glocklueng/gnuRadio-hw/usrp2/documentation/usrp2.JPG

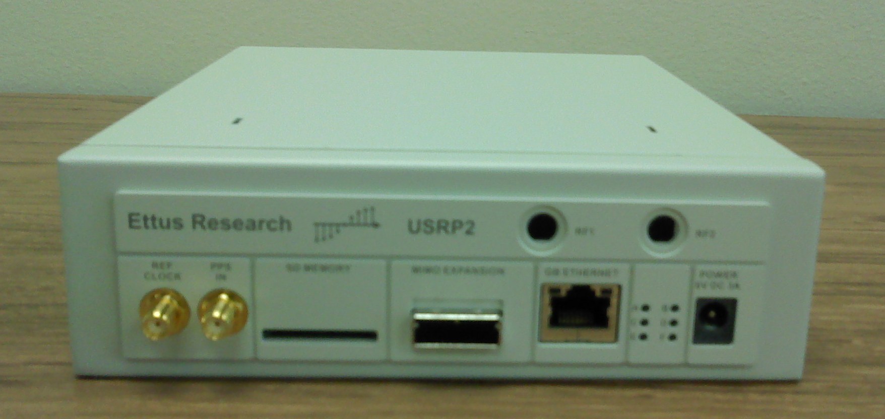
usrp2/documentation/usrp2.JPG
