glocklueng/gnuRadio-hw/usrp1/xy/USRP_2.JPG

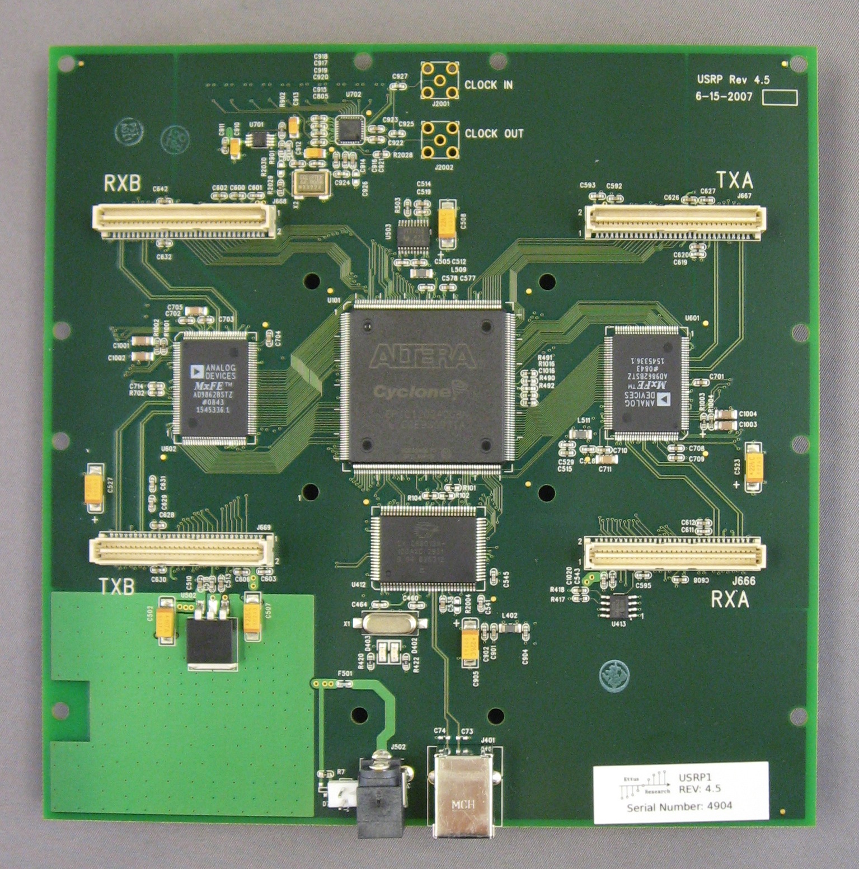
usrp1/xy/USRP_2.JPG
