glocklueng/gnuRadio-hw/usrp1/usrp-bom.xls

USRP-B REV B | 2006-01-31
Device | Value | Supplier | Part Number | Cal Chip Description | Footprint | Quantity | Refdes | Comments | Need | Have | Buy
CAPACITOR | 0.1uF | Cal Chip | GMC10X7R104K50NT | CAP CERAMIC 0603 X7R .1UF 10% 50V | 603 | 90 | C470 C510 C512 C513 C514 C515 C516 C522 C525 C530 C532 C534 C536 C538 C540 C542 C544 C546 C548 C551 C553 C555 C557 C559 C561 C563 C565 C566 C568 C570 C572 C575 C577 C579 C580 C582 C584 C586 C588 C590 C592 C594 C596 C598 C600 C602 C604 C606 C608 C610 C612 C614 C616 C618 C620 C622 C624 C626 C628 C630 C632 C634 C636 C638 C640 C642 C644 C701 C702 C703 C704 C706 C708 C709 C710 C712 C714 C803 C901 C903 C911 C914 C916 C917 C918 C919 C920 C921 C922 C923 |  | 9000 | 3000 | 6000
CAPACITOR | 10uF | Cal Chip | GMC31X7R106K16NT | CAP CERAMIC 1206 X7R 10UF 10% 16V | 1206 | 4 | C705 C707 C711 C713 | VOLTAGE, TOL., MATERIAL | 400 | 1000 | -600
CAPACITOR | 1uF | Cal Chip | GMC 31X7R105K25NT | CAP CERAMIC 1206 X7R 1UF 10% 16V | 1206 | 4 | C1001 C1002 C1003 C1004 |  | 400 | 1200 | -800
CAPACITOR | 220pF | Cal Chip | GMC10CG221J50NT | CAP CERAMIC 0603 NPO/COG 220PF 10% 50V | 603 | 75 | C1014 C1015 C1016 C1020 C505 C518 C519 C524 C526 C528 C529 C531 C533 C535 C537 C539 C541 C543 C545 C547 C549 C550 C552 C554 C556 C558 C560 C562 C564 C567 C569 C571 C573 C574 C576 C578 C581 C583 C585 C587 C589 C591 C593 C595 C597 C599 C601 C603 C605 C607 C609 C611 C613 C615 C617 C619 C621 C623 C625 C627 C629 C631 C633 C635 C637 C639 C641 C643 C645 C805 C902 C904 C924 C925 C927 |  | 7500 | 4800 | 2700
CAPACITOR | 22pF | Cal Chip | GMC10CG220J50NT | CAP CERAMIC 0603 NPO/COG 22PF 10% 50V | 603 | 2 | C460 C464 |  | 200 | 2500 | -2300
CAPACITOR | 470pF | Cal Chip | GMC10CG471J50NT | CAP CERAMIC 0603 NPO/COG 470PF 5% 50V | 603 | 1 | C912 |  | 100 | 2200 | -2100
CAPACITOR | NONE |  |  |  | 603 | 1 | C926 |  | 100 | 100 | 0
CONNECTOR_3 | POWER | DigiKey | SC1153-ND |  | RAPC722 | 1 | J502 |  | 100 | 0 | 100
CONNECTOR_4 | USB | DigiKey | WM17113-ND |  | USB | 1 | J401 |  | 100 | 0 | 100
CRYSTAL | 24 Mhz | DigiKey | XC742CT-ND |  | HC-49USMD | 1 | X1 |  | 100 | 400 | -300
FUSE | 3A | DigiKey | P11359-CT-10 |  | 603 | 1 | F501 |  | 100 | 0 | 100
HEADER4 | SIP4 | DNS |  |  | SIP4 | 1 | J1001
INDUCTOR | Ferrite Bead | DigiKey | 240-2405-1-ND |  | 1206 | 7 | L401 L402 L509 L510 L511 L600 L601 |  | 700 | 300 | 400
LED | CMD17-21VGC/TR8 | DigiKey | L62405CT-ND |  | unknown | 2 | D402 D403 |  | 200 | 0 | 200
POLARIZED_CAPACITOR | 100uF Tan Size-C LoESR | SMC | AVX TPSC107K010R0100 | 100UF 10V C LOW ESR 100mR | SIZE-C | 1 | C502 | 10V ESR RATING?? | 100 | 0 | 100
POLARIZED_CAPACITOR | 22uF Tan Size-C LoESR | SMC | DK PN 495-1522-2-ND | 22UF 10V C LOW ESR 100mR | SIZE-C | 5 | C507 C508 C523 C527 C905 | 10V ESR RATING?? | 500 | 200 | 300
POLARIZED_CAPACITOR | 4.7uF | SMC | AVX TAJA475K016RNJ | CAP TANT 4.7UF 10V A CASE 10% | 1206 | 3 | C910 C913 C915 | TANTALUM A CASE = 1206 | 300 | 800 | -500
RESISTOR | 0 | Cal Chip | RM06J000CT | 0603 0 OHM | 603 | 6 | R2002 R2003 R2029 R442 R859 R861 |  | 600 | 2500 | -1900
RESISTOR | 10 | Cal Chip | RM06F10R0CT | 0603 1% 10 OHM | 603 | 1 | R2028 | ALSO AVAILABLE IN 5% TOL RM06J100CT | 100 | 2500 | -2400
RESISTOR | 100 | Cal Chip | RM06F1000CT | 0603 1% 100 OHM | 603 | 4 | R1001 R1002 R1003 R1004 | ALSO AVAILABLE IN 5% TOL RM06J101CT | 400 | 3000 | -2600
RESISTOR | 100K | Cal Chip | RM06F1003CT | 0603 1% 100KR | 603 | 1 | R424 | ALSO AVAILABLE IN 5% TOL RM06J104CT | 100 | 3000 | -2900
RESISTOR | 10K | Cal Chip | RM06F1002CT | 0603 1% 10KR | 603 | 6 | R101 R102 R104 R490 R491 R492 | ALSO AVAILABLE IN 5% TOL RM06J103CT | 600 | 2500 | -1900
RESISTOR | 140K | Cal Chip | RM06F1403CT | 0603 1% 140KR | 603 | 1 | R901 |  | 100 | 3000 | -2900
RESISTOR | 1K | Cal Chip | RM06F1001CT | 0603 1% 1KR | 603 | 2 | R420 R422 | ALSO AVAILABLE IN 5% TOL RM06J102CT | 200 | 2500 | -2300
RESISTOR | 2.2K | Cal Chip | RM06J222CT | 0603 5% 2.2KR | 603 | 2 | R417 R418 |  | 200 | 3000 | -2800
RESISTOR | 240K | Cal Chip | RM06J244CT | 0603 5% 240KR | 603 | 1 | R503 |  | 100 | 2000 | -1900
RESISTOR | 4.12K | Cal Chip | RM06F4121CT | 0603 1% 4.12K | 603 | 1 | R903 |  | 100 | 3000 | -2900
RESISTOR | 4K | Cal Chip | RM06F4021CT | 0603 1% 4.02KR | 603 | 2 | R701 R702 | 4K NON STD VALUE 4.02K 1% | 200 | 3000 | -2800
RESISTOR | 50 | Cal Chip | RM06F49R9CT | 0603 1% 49.9 OHM | 603 | 6 | R1011 R1012 R1013 R1014 R1015 R1016 | 50 OHM IS NON STD VALUE 51 OHM 5% 49.9 OHM 1% ARE STD VALUES | 600 | 2500 | -1900
RESISTOR | 78.7K | Cal Chip | RM04F7872CT | 0402 1% 78.7K | 603 | 1 | R902 |  | 100 | 3000 | -2900
RESISTOR | NONE |  |  |  | 402 | 22 | R904 R905 R907 R908 R910 R911 R913 R914 R916 R917 R919 R920 R922 R923 R925 R926 R928 R929 R931 R932 R934 R935 R906 R909 R912 R915 R918 R921 R924 R927 R930 R933 R936 |  | 2200 | 8500 | -6300
RESISTOR | NONE |  |  |  | 603 | 6 | R2001 R2004 R2005 R2030 R858 R860
SMA | NONE |  |  |  | SMA_VERT | 2 | J2001 J2002
TPS77715PWP | TPS77715PWP | ETTUS |  |  | PWP-20 | 1 | U503 |  | 100 | 100 | 0
CTX286LVCT-ND | 64 Mhz | DigiKey, ETTUS | CTX286LVCT-ND |  | vctcxo | 1 | X2 |  | 100 | 400 | -300
24LC02B |  | ETTUS | Cross PN 24LCO24 |  | SO8 | 1 | U413 |  | 100 | 100 | 0
AD9513 |  | ETTUS |  |  | LFCSP32 | 1 | U702 |  | 100 |  | 100
AD9862 |  | ETTUS |  |  | LQFP128 | 2 | U601 U602 |  | 200 |  | 200
ADP3336 |  | ETTUS |  |  | MSOP8 | 1 | U701 |  | 100 | 150 | -50
CY7C68013-TQ100 |  | ETTUS | Cross PN CY7C68013A-100AXC | second cross CY7C68013-100AXC | TQFP100 | 1 | U412 |  | 100 | 4 | 96
EP1C12-PQ240 |  | ETTUS | Cross PN EP1C12Q240C8N |  | PQ240 | 1 | U101 |  | 100 | 82 | 18
LT1085CM-3.3 | LT1085CM-3.3 | ETTUS |  |  | LT1085 | 1 | U502 |  | 100 | 100 | 0
PMC64 | PMC 71436-2164 | ETTUS |  |  | pmc | 4 | J666 J667 J668 J669 |  | 400 | 5 | 395
USRP-B PCB REV 4.1 | PC board | ETTUS |  |  |  | 1 |  |  | 100 |  | 100
