glocklueng/gnuRadio-hw/daughterBoards/basic-lf/lfrx-bom.xls

Device | Value | Footprint | quantity | Supplied By | refdes
24LC025B |  | SO8 | 1 | ETTUS | U1
AD8132 |  | SO8 | 2 | ETTUS | U2 U3
CAPACITOR | .1uF | 603 | 1 | Bestek | C24
CAPACITOR | 82pF | 603 | 4 | Bestek | C22 C23 C25 C26
HEADER10 |  | CONNECTOR 5 2 | 1 | Bestek | J17
HEADER16 |  | CONNECTOR 8 2 | 3 | Bestek | J16 J24 J25
HEADER20 |  | CONNECTOR 10 2 | 1 | Bestek | J15
PMC64 |  | PMC-REVERSE | 1 | ETTUS | J2
RESISTOR | 0 | 603 | 1 | Bestek | R28
RESISTOR | 1K | 603 | 2 | Bestek | R6 R7
RESISTOR | 24.9 | 603 | 2 | Bestek | R32 R35
RESISTOR | 348 | 603 | 8 | Bestek | R30 R31 R33 R34 R36 R37 R38 R39
RESISTOR | 49.9 | 603 | 2 | Bestek | R3 R4 R5 R9 R10 R11
SMA |  | SMA | 2 | ETTUS | J18 J19
