glocklueng/gnuRadio-hw/daughterBoards/basic-lf/lftx-bom.xls

Device | Value | Footprint | quantity | Supplier | refdes
CAPACITOR | 0.1uF | 603 | 6 |  | C12 C20 C22 C23 C6 C8
CAPACITOR | 100pF | 603 | 2 |  | C31 C32
CAPACITOR | 1uF | 603 | 2 |  | C1 C2
CAPACITOR | 20pF | 603 | 2 |  | C14 C15
CAPACITOR | 220pF | 603 | 3 |  | C10 C21 C5
CAPACITOR | 22pF | 603 | 1 |  | C4
CAPACITOR | 4.7pF | 603 | 2 |  | C33 C34
HEADER10 |  | CONNECTOR 5 2 | 1 |  | J47
HEADER16 |  | CONNECTOR 8 2 | 3 |  | J46 J50 J51
HEADER20 |  | CONNECTOR 10 2 | 1 |  | J45
FERRITE BEAD |  | 1206 | 2 |  | FB1 FB2
RESISTOR | 0 | 603 | 1 |  | R29
RESISTOR | 178K | 603 | 1 |  | R2
RESISTOR | 225 | 603 | 4 |  | R3 R5 R6 R8
RESISTOR | 25 | 603 | 8 |  | R33 R34 R35 R36 R38 R39 R40 R41
RESISTOR | 500 | 603 | 4 |  | R32 R37 R4 R7
RESISTOR | 68.1K | 603 | 1 |  | R1
24LC025B | unknown | SO8 | 1 | ETTUS | U52
CAPACITOR | 4.7uF | 1206 | 2 | ETTUS | C11 C3
INDUCTOR | 22uH | 1206 | 2 | ETTUS | L1 L2
LT3462 |  | TSOT23 | 1 | ETTUS | U3
AD8047 |  | SO8 | 2 | ETTUS | U1 U2
PMC64 |  | PMC-REVERSE | 1 | ETTUS | J44
SMA5 |  | SMA_VERT | 2 | ETTUS | J48 J49
