glocklueng/gnuRadio-hw/daughterBoards/dbsrx/dbsrx-bom.xls

Device | Value | Mfg part number | Footprint | Qty | Supplier | Refdes | Cost
CAPACITOR | .01uF |  | 603 | 2 | Bestek | C83 C87
CAPACITOR | .1uF |  | 603 | 11 | Bestek | C100 C183 C184 C187 C24 C27 C61 C63 C68 C69 C84
CAPACITOR | .22uF |  | 603 | 2 | Bestek | C70 C71
CAPACITOR | 1000pF |  | 603 | 10 | Bestek | C124 C28 C74 C75 C76 C77 C78 C79 C80 C81
CAPACITOR | 100pF |  | 603 | 5 | Bestek | C25 C26 C64 C65 C97
CAPACITOR | 10nF |  | 603 | 1 | Bestek | C98
CAPACITOR | 200pF |  | 603 | 1 | Bestek | C261
CAPACITOR | 22pF |  | 603 | 4 | Bestek | C66 C67 C85 C86
CAPACITOR | 3300pF |  | 603 | 1 | Bestek | C59
CAPACITOR | 47pF |  | 603 | 4 | Bestek | C72 C73 C96 C99
POLARIZED_CAPACITOR | 100uF |  | EIA6032 | 1 | Bestek | C82
CONNECTOR_2 |  |  | CONNECTOR 1 2 | 1 | Bestek | J100 J101
HEADER16 |  |  | CONNECTOR 8 2 | 2 | Bestek | J24 J25
INDUCTOR | 27nH | Coilcraft 0603CS-27NX_BU | 603 | 2 | Bestek | L98 L100
INDUCTOR | MI1206K601R-00 |  | 1206 | 2 | Bestek | L600 L601
RESISTOR | 10 |  | 603 | 1 | Bestek | R193
RESISTOR | 1K |  | 603 | 4 | Bestek | R13 R21 R6 R7
RESISTOR | 2.21K |  | 603 | 1 | Bestek | R14
RESISTOR | 1K, 0.1% |  | 603 | 8 | Bestek | R17 R18 R19 R20 R65 R66 R67 R68 |  |  |  | CHANGED!!!!
RESISTOR | 4.7 |  | 603 | 1 | Bestek | R12
RESISTOR | 43.2 |  | 603 | 1 | Bestek | R9
RESISTOR | 50 |  | 603 | 5 | Bestek | R10 R15 R16 R71 R93
RESISTOR | 75 |  | 603 | 1 | Bestek | R11
RESISTOR | 86.6 |  | 603 | 1 | Bestek | R40
RESISTOR | NONE |  | 603 | 1 | NP | R22
 |  |  |  |  |  |  | Cost | Have | Short? | Ordered
PCB |  |  |  | 1 | Ettus |  | 15 | 0 | -100 | Yes
24LC024/SN |  |  | SO8 | 1 | Ettus | U1 | 0.5 | 100 | 0
SMA |  |  | SMA_VERT | 1 | Ettus | J3 | 1.5 | 100 | 0
MAX2118 |  |  | QFN40_6_EP | 1 | Ettus | U3 | 3.5 | 100 | 0
NDS355AN |  |  | SOT23 | 1 | Ettus | Q1 | 0.5 | 100 | 0
POLARIZED_CAPACITOR | 22uF |  | EIA6032 | 1 | Ettus | C182 | 1 | 100 | 0
PMC64 |  |  | PMC-REVERSE | 1 | Ettus | J2 | 1.35 | 100 | 0
AD8132 |  |  | SO8 | 2 | Ettus | U5 U6 | 3.8 | 0 | -200 | Yes
LM2940IMP |  |  | SOT223 | 1 | Ettus | U2 | 1 | 100 | 0
MGA82563 |  |  | SC70_6 | 1 | Ettus | U4 | 1.25 | 100 | 0
 |  |  |  |  |  |  | 29.4
