glocklueng/gnuRadio-hw/daughterBoards/rfx/flex400-bom.xls

FLEX 400
Type | Value | Footprint | Quantity | Refdes | Supplier | Part Number
CAPACITOR | .01uF | 603 | 14 | C159 C160 C161 C163 C172 C173 C183 C59 C60 C61 C63 C80 C81 C98 | CalChip | GMC10X7R103K50NT
CAPACITOR | .1uF | 603 | 18 | C3 C33 C82 C83 C84 C95 C120 C121 C124 C125 C129 C203 C209 C34 C35 C45 C5 C9 | CalChip | GMC10X7R104K50NT
CAPACITOR | 1000pF | 603 | 23 | C101 C103 C104 C108 C157 C158 C162 C184 C201 C202 C204 C205 C206 C54 C57 C58 C62 C64 C93 C94 C96 C170 C70 | CalChip | GMC10X7R102K50NT
CAPACITOR | 100pF | 603 | 3 | C105 C106 C97 | CalChip | GMC10CG101J50NT
CAPACITOR | 10uF | 1206 | 2 | C171 C71 | CalChip | GMC31X7R106K16NT
CAPACITOR | 12nF | 603 | 2 | C168 C68 | CalChip | GMC10X7R123K50NT
CAPACITOR | 12pF | 603 | 1 | C222 | CalChip | GMC10CG120J50NT
CAPACITOR | 150pF | 603 | 2 | C86 C90 | CalChip | GMC10CG151J50NT
CAPACITOR | 15pF | 603 | 1 | C102 | CalChip | GMC10CG150J50NT
CAPACITOR | 1uF | 603 | 10 | C107 C109 C122 C123 C164 C207 C240 C4 C46 C53 | CalChip | GMC10X7R105K16NT
CAPACITOR | 220pF | 603 | 7 | C128 C182 C186 C2 C200 C32 C8 | CalChip | GMC10CG221J50NT
CAPACITOR | 3.9pF | 603 | 4 | C221 C223 C65 C66 | CalChip | GMC10CG3R9B50NT
CAPACITOR | 390pF | 603 | 2 | C169 C69 | CalChip | GMC10CG391J50NT
CAPACITOR | 4.7pF | 603 | 2 | C88 C92 | CalChip | GMC10CG4R7B50NT
CAPACITOR | 470pF | 603 | 5 | C1 C10 C110 C111 C210 | CalChip | GMC10CG471J50NT
CAPACITOR | 68pF | 603 | 4 | C174 C175 C177 C178 | CalChip | GMC10CG680J50NT
CAPACITOR | 8.2pF | 603 | 4 | C165 C166 C87 C91 | CalChip | GMC10CG8R2B50NT
CAPACITOR | 820pF | 603 | 2 | C167 C67 | CalChip | GMC10CG821J50NT
CAPACITOR | 82pF | 603 | 2 | C85 C89 | CalChip | GMC10CG820J50NT
CAPACITOR | NONE | 603 | 4 | C185 C224 C225 C36
INDUCTOR | 0.68uH | 1008 | 2 | L1 L2 | Mouser | NLV25T-R68J-PF
INDUCTOR | 1.2uH | 1008 | 2 | L3 L4 | Mouser | NLV25T-1R2JPF
INDUCTOR | 100nH | 603 | 6 | L101 L104 L113 L180 L181 L98 | CoilCraft | 0603CS-R10XJBW
INDUCTOR | 10nH | 603 | 1 | L102 | CoilCraft | 0603CS-10NXJBW
INDUCTOR | 16nH | 603 | 2 | L182 L183 | CoilCraft | 0603CS-16NXJBW
INDUCTOR | 22nH | 603 | 2 | L224 L225 | CoilCraft | 0603CS-22NXGLW
INDUCTOR | 4.3nH | 402 | 4 | L105 L116 L31 L32 | CoilCraft | 0402CS-4N3XGLW
INDUCTOR | 47nH | 603 | 2 | L80 L81 | CoilCraft | 0603CS-47NXGLW
INDUCTOR | 6.8nH | 603 | 1 | L99 | CoilCraft | 0603CS-6N8XJBW
INDUCTOR | 620nH | 1008 | 4 | L186 L187 L190 L191 | CoilCraft | 1008CS-621XJBC
INDUCTOR | 8.2nH | 603 | 2 | L82 L83 | CoilCraft | 0603CS-8N2XJBW
INDUCTOR | NONE | 603 | 3 | L221 L222 L223
INDUCTOR | Ferrite Bead | 1206 | 7 | L103 L112 L114 L202 L5 L6 L7 | DigiKey | 240-2405-2-ND
RESISTOR | 0 | 603 | 11 | R117 R130 R132 R136 R142 R35 R40 R42 R46 R64 R95 | CalChip | RM06J000CT
RESISTOR | 1.6K | 603 | 2 | R121 R32 | CalChip | RM06J162CT
RESISTOR | 10 1% | 603 | 3 | R103 R110 R9 | CalChip | RM06F10R0CT
RESISTOR | 100 1% | 603 | 4 | R104 R111 R7 R8 | CalChip | RM06F1000CT
RESISTOR | 10K | 603 | 2 | R249 R250 | CalChip | RM06F1002CT
RESISTOR | 140K | 603 | 3 | R140 R201 R62 | CalChip | RM06F1403CT
RESISTOR | 174 | 603 | 1 | R14 | CalChip | RM06F1740CT
RESISTOR | 1K | 603 | 2 | R10 R11 | CalChip | RM06F1001CT
RESISTOR | 2 | 603 | 4 | R3 R4 R5 R6 | CalChip | RM06J2R0CT
RESISTOR | 200 | 603 | 4 | R47 R48 R49 R50 | CalChip | RM06F2000CT
RESISTOR | 210K | 603 | 2 | R141 R63 | CalChip | RM06F2103CT
RESISTOR | 3.32K | 603 | 2 | R152 R83 | CalChip | RM06F3321CT
RESISTOR | 3.3K | 603 | 2 | R120 R38 | CalChip | RM06J332CT
RESISTOR | 4.02K | 603 | 1 | R68 | CalChip | RM06F4021CT
RESISTOR | 4.7K | 603 | 2 | R119 R33 | CalChip | RM06F4751CT
RESISTOR | 470 | 402 | 4 | R105 R106 R30 R31 | CalChip | RM04J471CT
RESISTOR | 49.9 1% | 603 | 7 | R101 R102 R108 R109 R107 R37 R118 | CalChip | RM06F49R9CT
RESISTOR | 57.6 | 603 | 1 | R18 | CalChip | RM06F57R6CT
RESISTOR | 64.9K | 603 | 2 | R151 R81 | CalChip | RM06F6492CT
RESISTOR | 78.7K | 603 | 2 | R80 R150 R202 | CalChip | RM04F7872CT
RESISTOR | 95.3 | 603 | 2 | R61 R87 | CalChip | RM06F95R3CT
RESISTOR | NONE | 603 | 14 | R115 R116 R133 R134 R135 R153 R34 R36 R43 R44 R45 R84 R96 R97
CONNECTOR_2 |  | CONNECTOR2 | 2 | J100 J3 | TTI Inc | 22-28-4021
HEADER16 |  | CONNECTOR16 | 2 | J101 J24 | Mouser | 10-89-7402 | Normally 10-89-7162
HEADER16, AN 8X2, WILL BE A 20X2 THAT WILL BE CUT DOWN BY ASEMTEC
PCB FAB REV 1 |  | Flex 400 Rev 1 |  |  | Ettus
Consigned Parts |  |  |  |  | Ettus
RF3315 |  | SOT89 | 1 | U105 | Ettus
CTX286LVCT-ND |  | VCTCXO | 2 | X1 X101 | Ettus
24LC025B |  | SO8 | 2 | U1 U102 | Ettus
74AC04 |  | SO14 | 1 | U204 | Ettus
AD8348 |  | TSSOP28/0.65 | 1 | U2 | Ettus
AD8345 |  | TSSOP16-65-PAD | 1 | U101 | Ettus
ADF4360-7 |  | CP-24 | 2 | U103 U3 | Ettus
ADP3336 |  | MSOP8 | 5 | U110 U111 U203 U5 U6 | Ettus
SMA |  | SMA_VERT | 2 | J200 J202 | Ettus
AD8052 |  | SO8 | 1 | U7 | Ettus
HMC174MS8 |  | MSOP8 | 2 | U202 U209 | Ettus
HMC311ST89 |  | SOT89 | 1 | U104 | Ettus
MGA6x563 |  | SOT363 | 1 | U4 | Ettus
PMC64 |  | PMC-REVERSE | 2 | J1 J102 | Ettus
TANTALUM | 4.7uF | 1206 | 7 | C117 C126 C127 C208 C47 C6 C7 | Ettus
