glocklueng/gnuRadio-hw/daughterBoards/rfx/flex900-bom.xls

2006-03-28 | revised by Mike Ysenbart SEMS
Device | Value | Footprint | Qty | Supplier | P/N | REFDES | stockparts
24LC025B |  | SO8 | 2 | ETTUS |  | U1 U102
74AC04 |  | SO14 | 1 | ETTUS |  | U204
AD8347 |  | TSSOP28/0.65 | 1 | ETTUS |  | U2
AD8349 |  | TSSOP16-65-PAD | 1 | ETTUS |  | U101
ADF4360-3 |  | CP-24 | 2 | ETTUS |  | U103 U3
ADP3336 |  | MSOP8 | 5 | ETTUS |  | U110 U111 U203 U5 U6
SMA |  | SMA | 2 | ETTUS |  | J200 J202
RF3315 |  | SOT89 | 1 | ETTUS |  | U105
SAWTEK856327 |  | SAWTEK856327 | 1 | ETTUS |  | FIL1
VCTCXO |  | CTX286LVCT-ND | 2 | ETTUS |  | X1 X101
AD8052 |  | SO8 | 1 | ETTUS |  | U7
HMC574MS8 |  | MSOP8 | 2 | ETTUS |  | U202 U209 | 2006-02-23
MGA82563 |  | SOT363 | 2 | ETTUS |  | U104 U4
PMC64 |  | PMC-REVERSE | 2 | ETTUS | Bottom of board | J1 J102
CAPACITOR | .01uF | 10% 50V 0603 | 11 | CalChip | GMC10X7R103K50NT | C108 C112 C161 C163 C172 C173 C183 C61 C63 C80 C81
CAPACITOR | 0.1uF | 10%…50V…0603 | 24 | CalChip | GMC10X7R104K50NT | C120 C121 C124 C125 C129 C203 C209 C3 C33 C34 C35 C45 C5 C82 C83 C84 C9 C95 C159 C160 C59 C60 C74 C98
INDUCTOR | 4.7nH | NPO/COG 50V..+/- 0.1pF 0603 | 1 | CoilCraft | 0603CS-4N7XJLW | C102
CAPACITOR | 1000pF | 10%..50V..0603 | 9 | CalChip | GMC10X7R102K50NT | C162 C170 C184 C54 C62 C64 C67 C70 C167
CAPACITOR | 220pF | 5%..50V..0603 | 25 | CalChip | GMC10CG221J50NT | C101 C104 C105 C106 C157 C158 C201 C202 C204 C205 C206 C57 C58 C75 C93 C94 C96 C97 C128 C182 C186 C2 C200 C32 C8
CAPACITOR | 10uF | 10%..16V..1206 | 2 | CalChip | GMC31X7R106K16NT | C171 C71 | stock
CAPACITOR | 120pF | NPO/COG.5%.50V.0603 | 2 | CalChip | GMC10CG121J50NT | C175 C178
CAPACITOR | 150pF | NPO/COG.5%.50V.0603 | 2 | CalChip | GMC10CG151J50NT | C86 C90
CAPACITOR | 6pF | NPO/COG.50V | 1 | CalChip | GMC10CG6R0B50NT | C103
CAPACITOR | 1uF | 10%.16V..0603 | 10 | Digi-Key | 490-1536-1-ND | C107 C109 C122 C123 C164 C207 C240 C4 C46 C53
CAPACITOR | 4.7pF | NPO/COG..50V..0603 | 3 | CalChip | GMC10CG4R7B50NT | C88 C92 C199
CAPACITOR | 470pF | NPO/COG..5%.50V.0603 | 7 | CalChip | GMC10CG471J50NT | C1 C10 C69 C110 C111 C169 C210 | stock
CAPACITOR | 47pF | NPO/COG.5%.50V.0603 | 2 | CalChip | GMC10CG470J50NT | C174 C177
CAPACITOR | 8.2pF | NPO/COG.50V.0603 | 2 | CalChip | GMC10CG8R2B50NT | C87 C91
CAPACITOR | 82pF | NPO/COG.5%.50V.0603 | 2 | CalChip | GMC10CG820J50NT | C85 C89
CAPACITOR | 4.3pF | NPO/COG.10%.50V 1.2pF.0603 | 4 | CalChip | GMC10CG4R3B50NT | C65 C66 C165 C166
CAPACITOR | 0.015uF | 10%..50V..0603 | 2 | CalChip | GMC10X7R153K50NT | C68 C168
CAPACITOR | NONE | 603 | 2 | DNS |  | C185 C36
POLARIZED_CAPACITOR | 4.7uF | 1206 | 7 | AVX | TAJA475K016RNJ | C117 C126 C127 C208 C47 C6 C7 | stock
HEADER16 |  | 0.1" Header 20X2 | 2 | Allied Elect. | 10-89-7402 | J101 J24
CONNECTOR_2 |  | 0.1" Header 2X1 | 2 | Digi-Key | WM6602-ND | J100 J3 | 2006-02-22
INDUCTOR | 0.68uH | 1008 | 2 | Digi-Key | 445-1723-1-ND | L1 L2
INDUCTOR | 1.2uH | 1008 | 2 | Digi-Key | 445-1726-1-ND | L3 L4
INDUCTOR | 47nH | 603 | 7 | CoilCraft | 0603CS-47NXJLW | L101 L113 L98 L80 L81 L180 L181
INDUCTOR | 8.7nH | 603 | 5 | CoilCraft | 0603CS-8N7XJLW | L104 L82 L83 L182 L183
INDUCTOR | 330nH | 1008 | 4 | Digi-Key | PCD1214CT-ND | L186 L187 L190 L191
INDUCTOR | Ferrite Bead | 1206 | 9 | Digi-Key | 240-2405-1-ND | L103 L108 L112 L114 L202 L5 L6 L7 L8
RESISTOR | 0 | 603 | 13 | CalChip | RM06J000CT | R103 R110 R117 R130 R132 R136 R142 R35 R40 R42 R46 R64 R95
RESISTOR | 10 | 10 Ohms …….0603 | 1 | CalChip | RM06F10R0CT | R9
RESISTOR | 100 | 100 Ohms….…0603 | 2 | CalChip | RM06F1000CT | R7 R8
RESISTOR | 10K | 1%..…..0603 | 2 | Cal Chip | RM06F1002CT | R249 R250
RESISTOR | 140K | 1%…....0603 | 3 | Cal Chip | RM06F1403CT | R140 R201 R62
RESISTOR | 1K | 1%..…..0603 | 1 | CalChip | RM06F1001CT | R11
RESISTOR | 2 | 2 Ohm..5%…....0603 | 4 | CalChip | RM06J2R0CT | R3 R4 R5 R6
RESISTOR | 200 | 200 ohm 1%…….0603 | 6 | CalChip | RM06F2000CT | R18 R19 R47 R48 R49 R50
RESISTOR | 210K | 210K ohm 1%….…0603 | 2 | CalChip | RM06F2103CT | R141 R63
RESISTOR | 240 | 240 ohm …0.1%….…0603 | 2 | Digi-Key | RR08P240BCT-ND | R104 R111
RESISTOR | 3.32K | 1%…....0603 | 2 | CalChip | RM06F3321CT | R261 R262
RESISTOR | 4.7K | 1%…….0603 | 2 | CalChip | RM06F4751CT | R119 R33
RESISTOR | 40.2 | 1%…….0603 | 4 | CalChip | RM06F40R2CT | R101 R102 R108 R109
RESISTOR | 50 | 49.9 Ohm 1%…….0603 | 2 | CalChip | RM06F49R9CT | R118 R37
RESISTOR | 64.9K | 1%…….0603 | 2 | CalChip | RM06F6492CT | R151 R81
RESISTOR | 78.7K | 1%…….0603 | 3 | Cal Chip | RM04F7872CT | R150 R202 R80 | stock
RESISTOR | 95.3 | 1%…….0603 | 2 | CalChip | RM06F95R3CT | R61 R87
RESISTOR | NONE | 603 | 15 | DNS |  | R1 R115 R116 R133 R134 R135 R153 R34 R36 R43 R44 R45 R84 R96 R97
RESISTOR | 2K | 1%…….0603 | 5 | CalChip | RM06F2001CT | R10, R32,R38 R120 R121
PCB Fab |  | Flex2400……rev 1.1
NOTES: In line item #38, for this build only, we are using 40 pin breakaway headers which are to clipped down to the appropriate size (8x2) with diagonal cutters.
Asemtec is to do this cutting.
