glocklueng/gnuRadio-hw/daughterBoards/tvrx/tvrx-bom.xls

refdes | device | value | footprint | quantity | Each | Cost | Supplier | Notes
C1 C2 C3 C4 C83 | CAPACITOR | .1uF | 603 | 5 | 0 | 0
C5 C6 | CAPACITOR | 10pF | 603 | 2 | 0 | 0
C101 C103 C105 C107 | CAPACITOR | 470pF | 603 | 4 | 0 | 0
R10 R17 | RESISTOR | 0 | 603 | 2 | 0 | 0
R6 | RESISTOR | 1.57K | 603 | 1 | 0 | 0
R12 R14 R16 R8 | RESISTOR | 10K | 603 | 6 | 0 | 0
R5 | RESISTOR | 1K | 603 | 1 | 0 | 0
R2 R4 R7 R9 | RESISTOR | 2.2K | 603 | 2 | 0 | 0
C82 | POLARIZED_CAPACITOR | 22uF | EIA6032 | 1 | 0.12 | 0.12
C102 C104 C106 C108 | POLARIZED_CAPACITOR | 4.7uF | 1206 | 4 | 0.04 | 0.16
Q1 Q2 | NDS355AN |  | SOT23 | 2 | 0.17 | 0.34
U1 | 24LC024/SN |  | SO8 | 1 | 0.26 | 0.26 | Ettus
U2 | MT4937DI5 |  | MT4937DI5 | 1 | 23.06 | 23.06 | Ettus
U3 | LM2940IMP-5.0 |  | SOT223 | 1 | 0.89 | 0.89 | Ettus has 35 of these
U4 | AD8602 | AD8602 | SO8 | 1 | 0.45 | 0.45
J2 | PMC64 |  | PMC-REVERSE | 1 | 1.45 | 1.45
R1 R11 R13 R3 | RESISTOR | NONE | 603 | 4 | 0 | 0 | Do Not populate
J24 J25 | HEADER16 | NONE | CONNECTOR 8 2 | 2 | 0 | 0 | Do not populate
 | PCB |  |  | 1 | 3 | 3
 | Assembly |  |  | 1 | 0 | 5
 |  |  |  |  |  | 34.73
