glocklueng/gnuRadio-hw/daughterBoards/dbsrx/DBSRX-LF Rev. 2.2 1-10-07 MASTER.xls

DBSRX-LF Rev. 2.2 |  | Revised by M.Ysenbart of SEMS 1-10-07
Item Number | Device | Value | Footprint | Quantity | Supplier | Reference Designation | Part Number | Manufacturer | RoHS | NOTES
1 | Serial EEPROM | 2KB, 2.5V to 5.5V | SOIC-8 | 1 | WM | U1 | 24LC024/SN | MICROCHIP | YES
2 | AMPLIFIER | 350 MHz, +2.5V to +/- 5.5V | SOIC-8 | 2 | WM | U5 U6 | AD8132ARZ | ANALOG DEVICES | YES
3 | CAPACITOR | .01uF, 10%, 50V | 603 | 6 | CALCHIP | C83 C87 C98 C67 C85 C86 | GMC10X7R103K50NT-LF | CALCHIP | YES
4 | CAPACITOR | .1uF, 10%, 50V | 603 | 11 | CALCHIP | C100 C183 C184 C187 C24 C27 C61 C63 C68 C69 C84 | GMC10X7R104K50NT-LF | CALCHIP | YES
5 | CAPACITOR | .22uF, 10%, 16V OR 25V | 603 | 2 | CALCHIP | C70 C71 | GMC10X7R224K25NT-LF | CALCHIP | YES
6 | CAPACITOR | 1000pF, 10%, 50V | 603 | 12 | CALCHIP | C124 C261 C262 C28 C74 C75 C76 C77 C78 C79 C80 C81 | GMC10X7R102K50NT-LF | CALCHIP | YES
7 | CAPACITOR | 100pF, 5%, 50V | 603 | 5 | CALCHIP | C25 C26 C64 C65 C97 | GMC10CG101J50NT-LF | CALCHIP | YES
9 | CAPACITOR | 22pF, 10%, 50V, NPO/COG | 603 | 1 | CALCHIP | C66 | GMC10CG220J50NT-LF | CALCHIP | YES
10 | CAPACITOR | 3300pF, 10%, 50V | 603 | 1 | CALCHIP | C59 | GMC10X7R332K50NT-LF | CALCHIP | YES
11 | CAPACITOR | 47pF, 5%, 50V, NPO/COG | 603 | 4 | CALCHIP | C72 C73 C96 C99 | GMC10CG470J50NT-LF | CALCHIP | YES
12 | CONNECTOR_2 | 2POS .100 VERT TIN | CONNECTOR | 2 | WM | J100 J101 | 22-28-4021 | MOLEX | YES
13 | HEADER16 | VERT BRKAWAY 16P dual row | CONNECTOR | 2 | WM | J24 J25 | 10-89-7162 | MOLEX | YES
14 | INDUCTOR | 27nH, 5% | 603 | 2 | COILCRAFT | L100 L98 | 0603CS-27NXJLW | COILCRAFT | YES
15 | INDUCTOR | FERRITE CHIP 600 OHM SMD | 1206 | 2 | DK | L600 L601 | MI1206K601R-10 | STEWARD | YES
16 | LINEAR, SINGLE OUTPUT REGULATOR | IC 5V 1A LDO VREG | SOT223 | 1 | NEWARK | U2 | LM2940IMP-5.0/NOPB | NATIONAL SEMI | YES
17 | DBS CONV. TUNER |  | QFN40_6_EP | 1 | W.MICRO | U3 | MAX2118UTL+ | MAXIM | YES | MATT HAS
18 | IC AMP MMIC GAAS SOT-363 | 3V | SOT363 | 1 | W.MICRO | U4 | MGA-82563-BLKG | AVAGO TECH. | YES
19 | NMOS_TRANSISTOR | MOSFET N-CH 30V 1.7A | SOT23 | 1 | MOUSER | Q1 | NDS355AN | FAIRCHILD SEMI. | YES | MATT HAS
20 | PMC64 | PMC RECEPTACLE SMT | PMC-REVERSE | 1 | W.MICRO | J2 | 71439-0164 | MOLEX | YES
21 | POLARIZED_CAPACITOR | 100uF, 10V, 10%, Tantalum | EIA6032 | 1 | CALCHIP | C82 | TCKIA107CT-LF | CALCHIP | YES
22 | POLARIZED_CAPACITOR | 22uF, 10V, 10%, Tantalum | EIA6032 | 1 | CALCHIP | C182 | TCKIA226CT | CALCHIP | YES
23 | RESISTOR | 10 | 603 | 2 | CALCHIP | R193 R195 | RM06F10R0CT-LF | CALCHIP | YES
24 | RESISTOR | 1K, 1% | 603 | 12 | CALCHIP | R13 R21 R6 R7 R17 R18 R19 R20 R65 R66 R67 R68 | RM06F1001CT-LF | CALCHIP | YES
25 | RESISTOR | 2.2K | 603 | 1 | CALCHIP | R14 | RM06J222CT-LF | CALCHIP | YES
27 | RESISTOR | 4.7, 5% | 603 | 1 | CALCHIP | R12 | RM06J4R7CT-LF | CALCHIP | YES
28 | RESISTOR | 43.2 | 603 | 1 | CALCHIP | R9 | RM06F43R2CT-LF | CALCHIP | YES
29 | RESISTOR | 49.9 | 603 | 5 | CALCHIP | R10 R15 R16 R71 R93 | RM06F49R9CT-LF | CALCHIP | YES
30 | RESISTOR | 75 | 603 | 1 | CALCHIP | R11 | RM06F75R0CT-LF | CALCHIP | YES
31 | RESISTOR | 86.6 | 603 | 1 | CALCHIP | R40 | RM06F86R6CT-LF | CALCHIP | YES
32 | RESISTOR | NONE | 603 | 2 |  | R194 R22
33 | CONNECTOR | CONNECTOR | SMA_VERT | 1 | WM | J3 | 142-0701-231 | EMERSON | YES | MATT HAS LTI-SASF54GT
 | ..END
 | SMA5
 | ..END
NOTES | 1. 1/15/07 Changed R17 R18 R19 R20 R65 R66 R67 R68
 | from 250, 0.10%, 0603 to 1K, 0.1%, 0603.
 | 2. 1/15/07 Changed R17 R18 R19 R20 R65 R66 R67 R68
 | from 1K, 0.1%, 0603 to 1K, 1%, 0603
