glocklueng/gnuRadio-hw/usrp2/documentation/usrp2.pdf

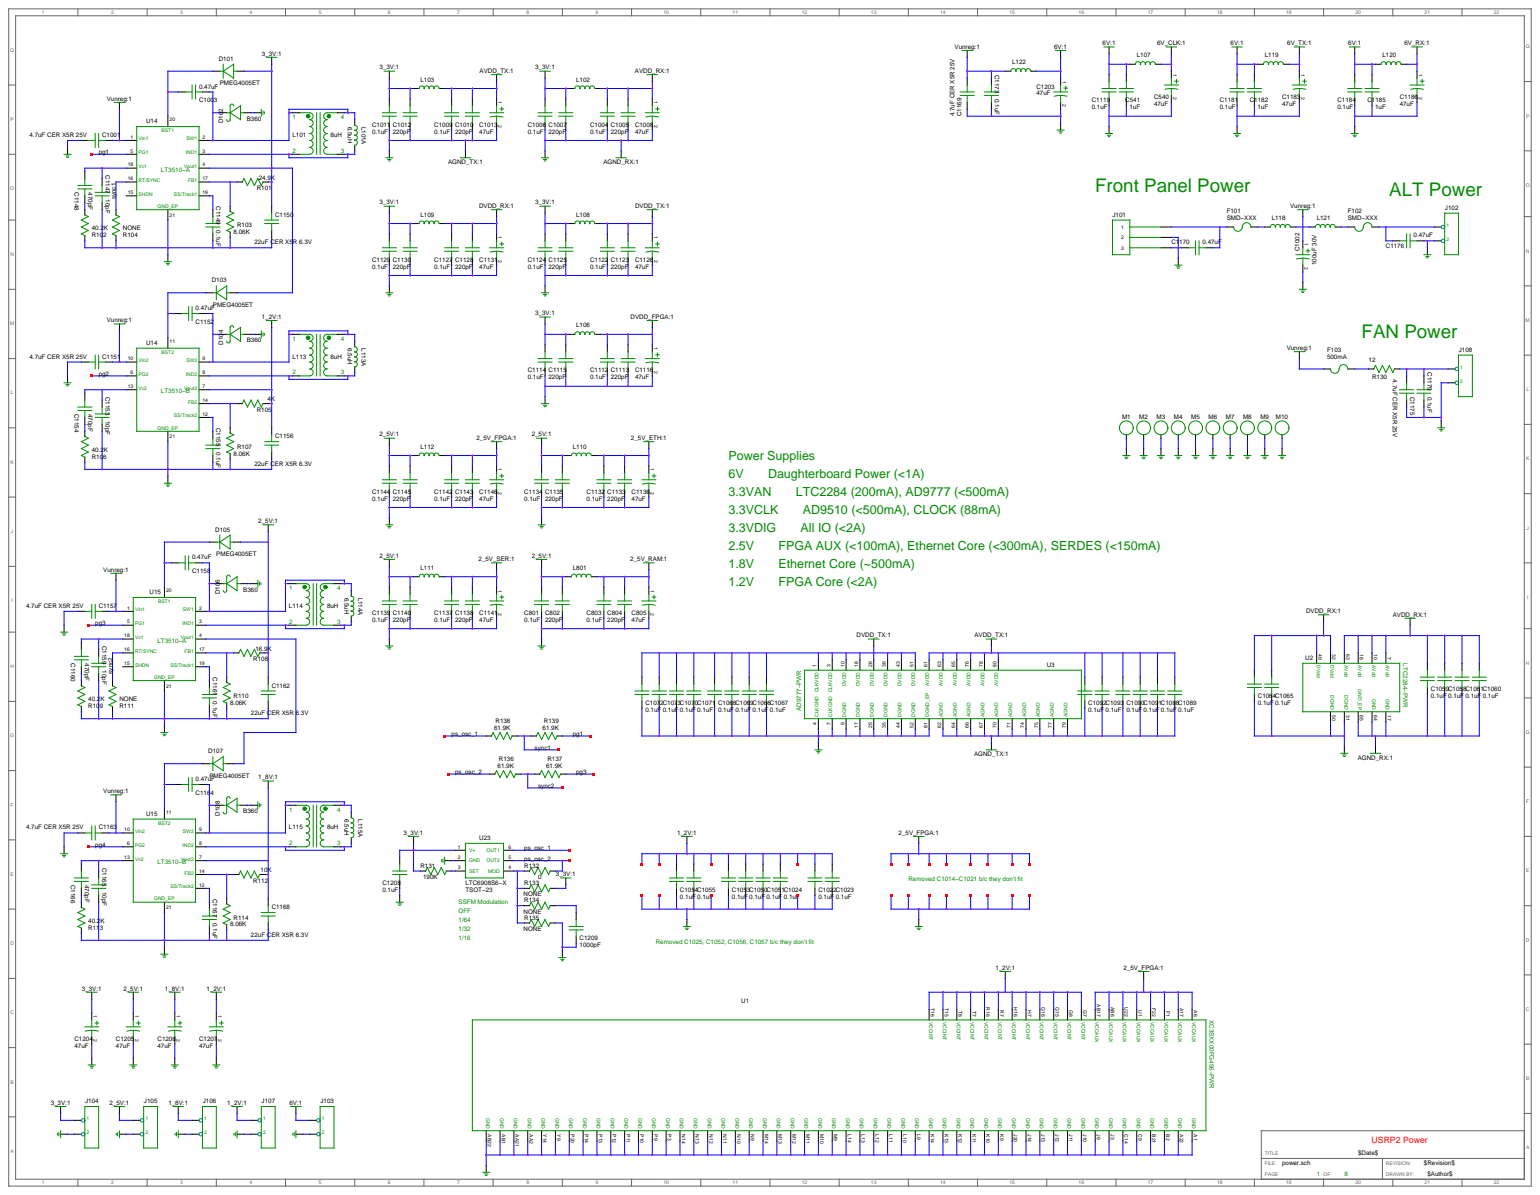
[picture p3: page 1]

Removed C1014−C1021 b/c they don’t fit

Removed C1025, C1052, C1056, C1057 b/c they don’t fit

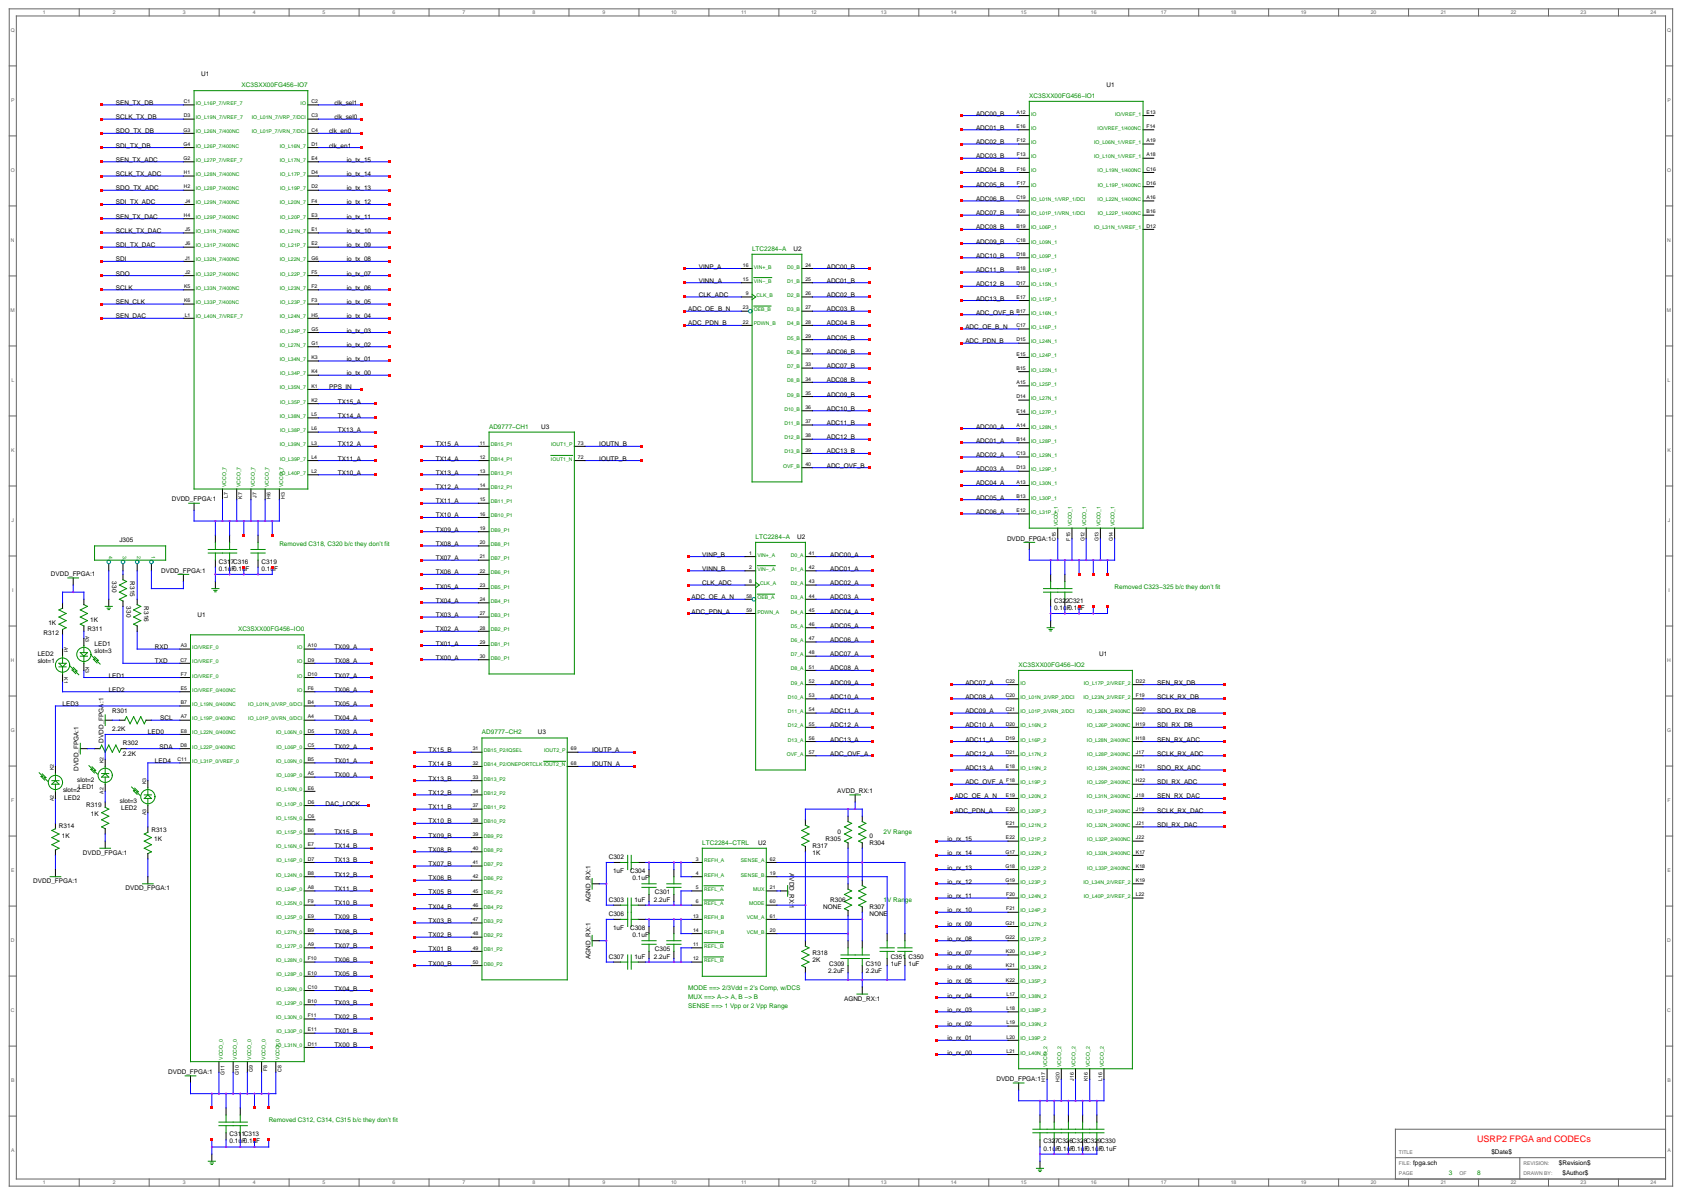
[picture p4: page 2]

Removed C318, C320 b/c they don’t fit

Removed C323−325 b/c they don’t fit

MODE ==> 2/3Vdd = 2’s Comp, w/DCS
MUX ==> A−> A, B −> B
SENSE ==> 1 Vpp or 2 Vpp Range

Removed C312, C314, C315 b/c they don’t fit

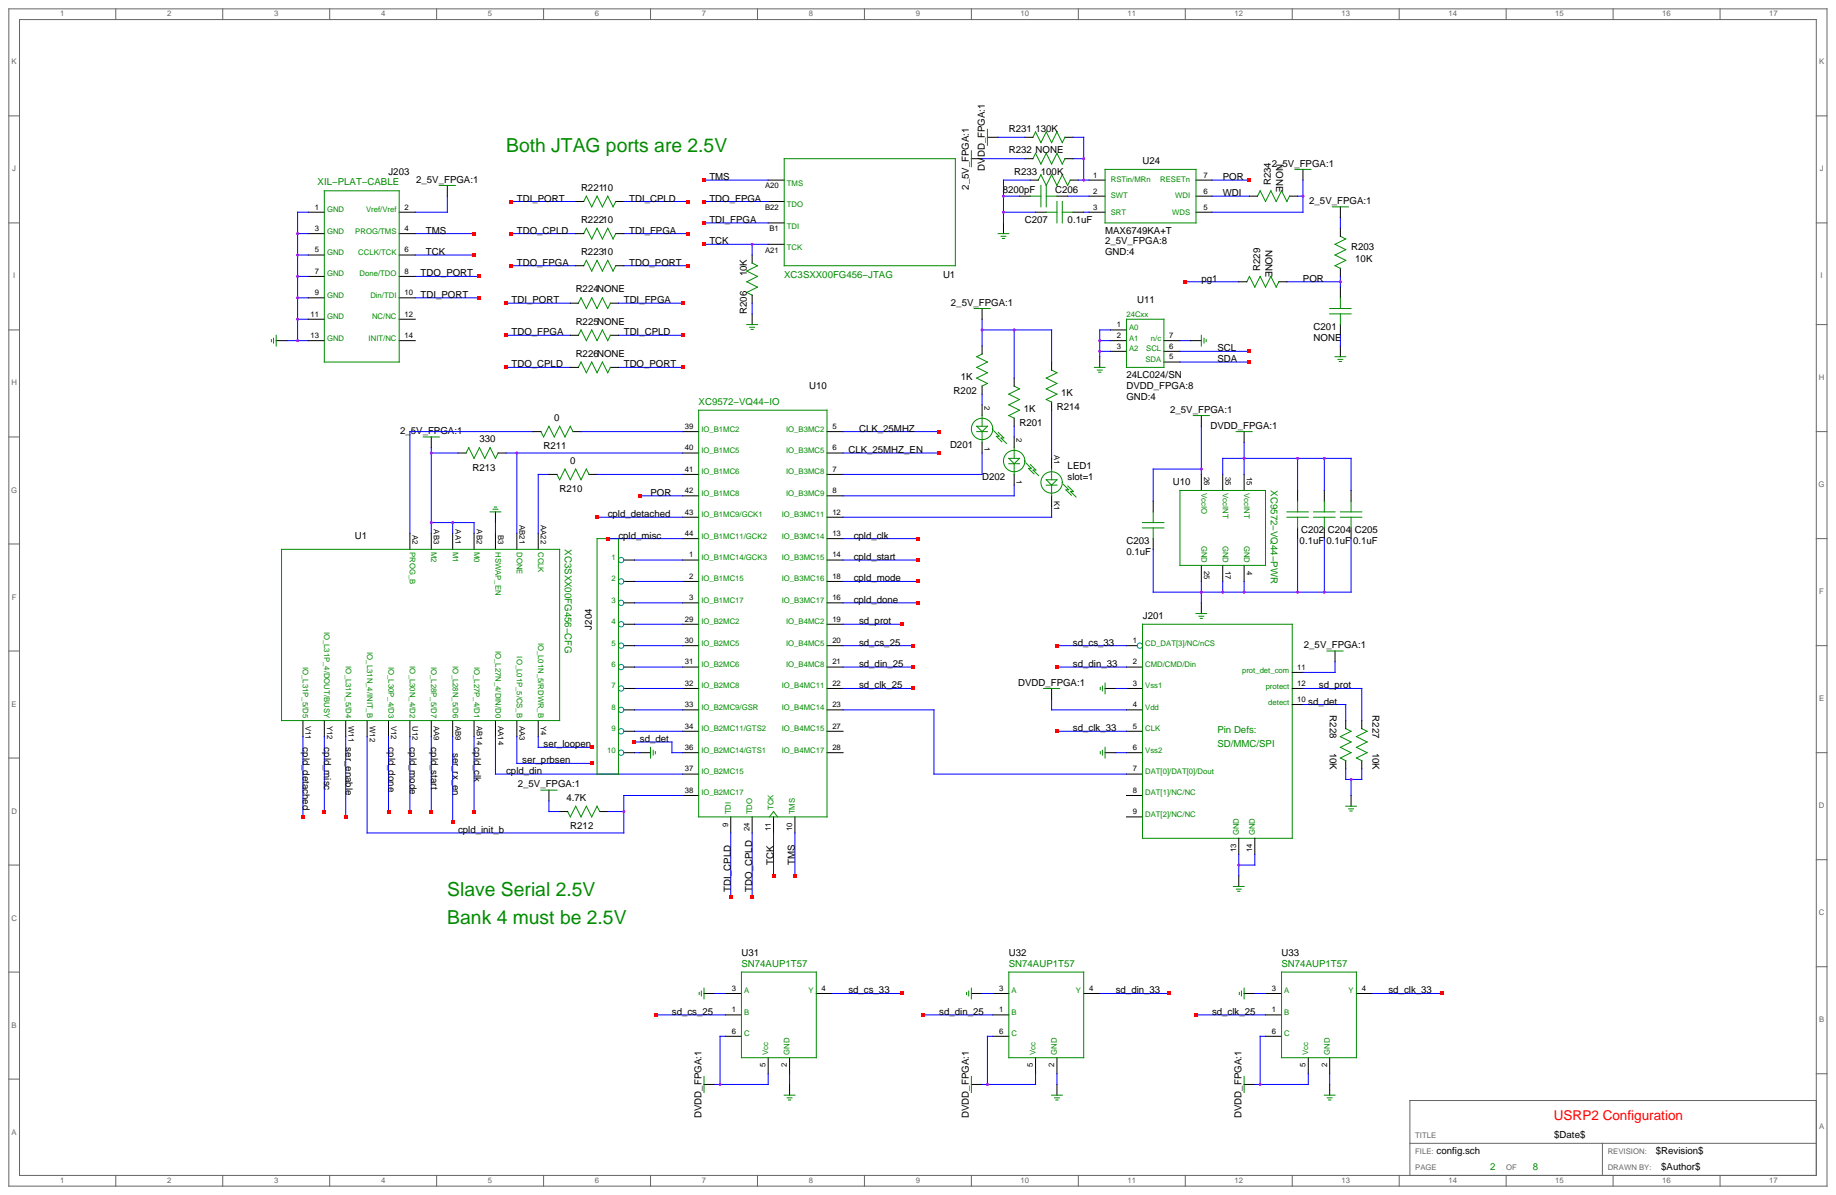
[picture p5: page 3]

Both JTAG ports are 2.5V

sd_det

cpld_din

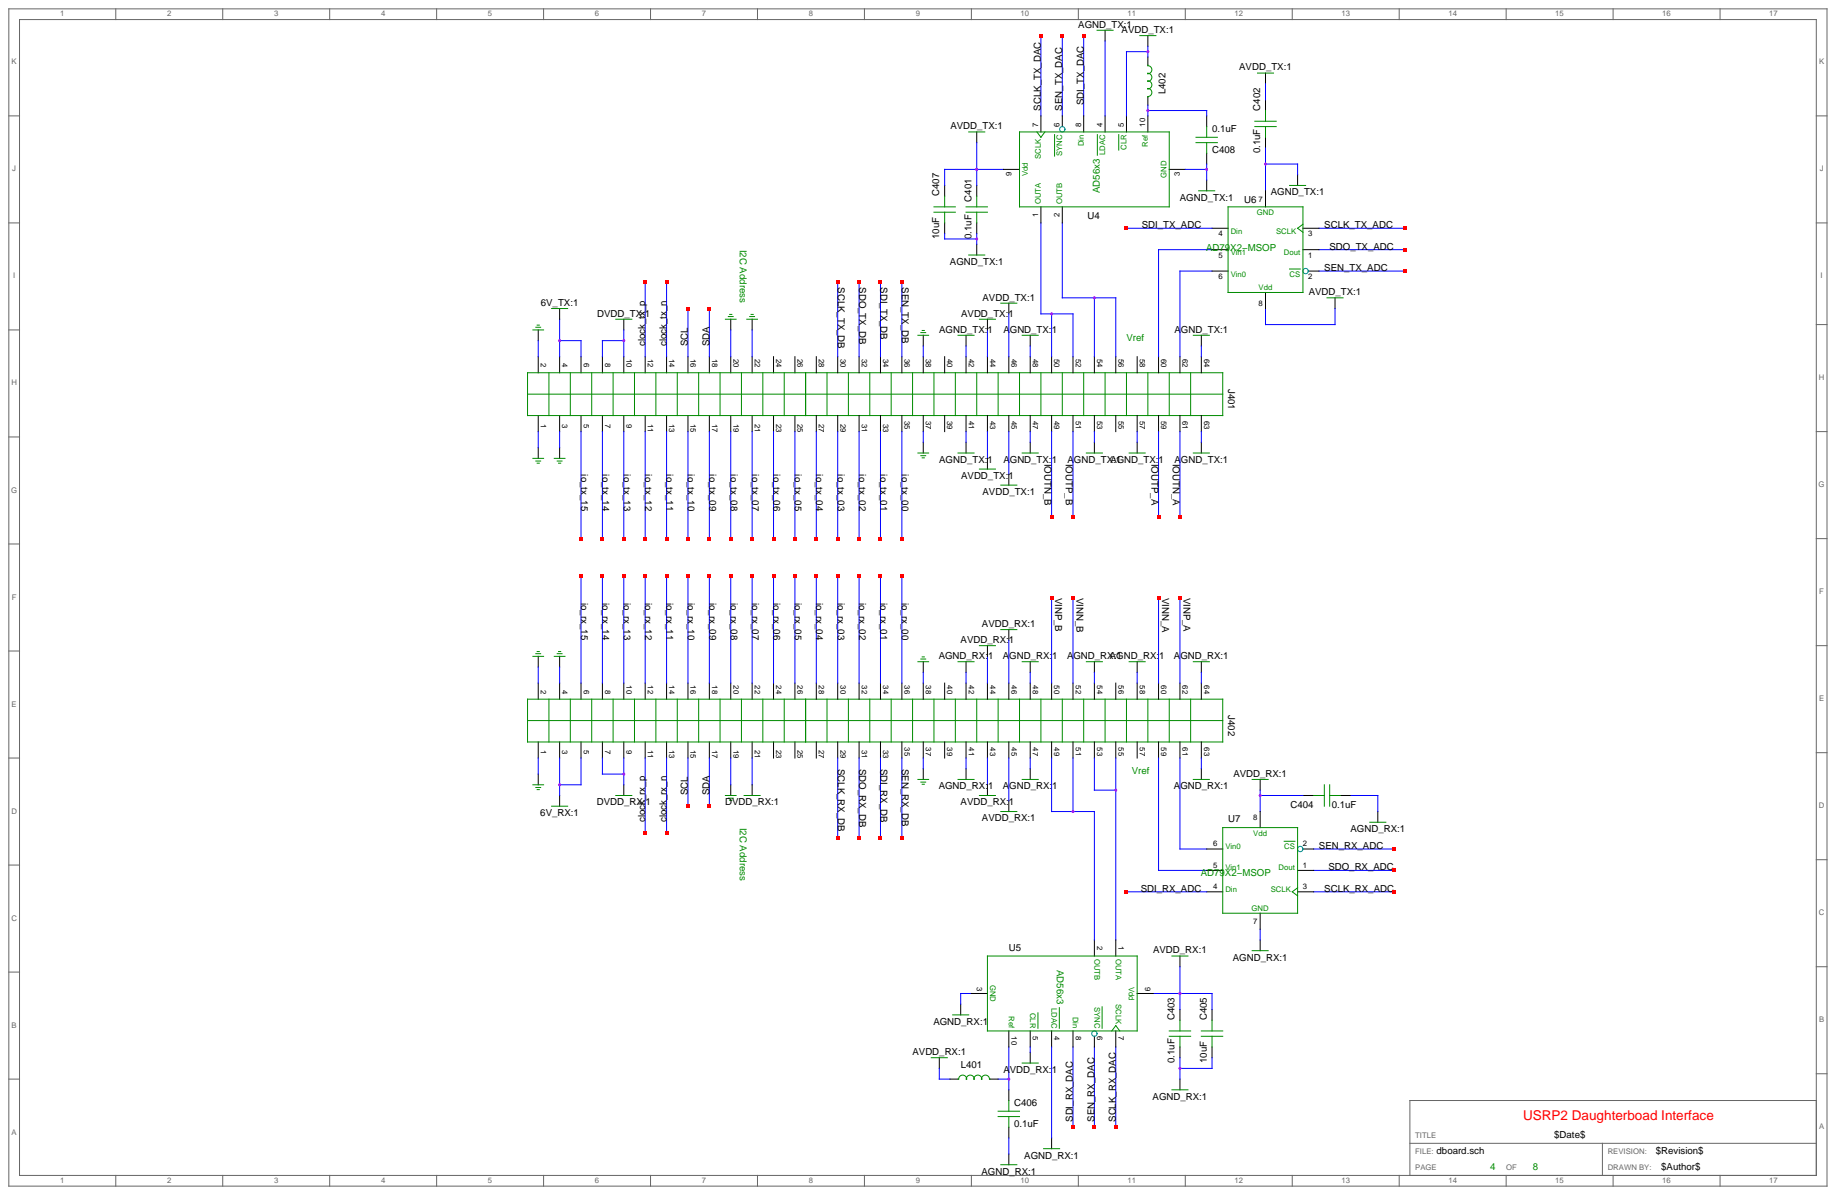
[picture p6: page 4]

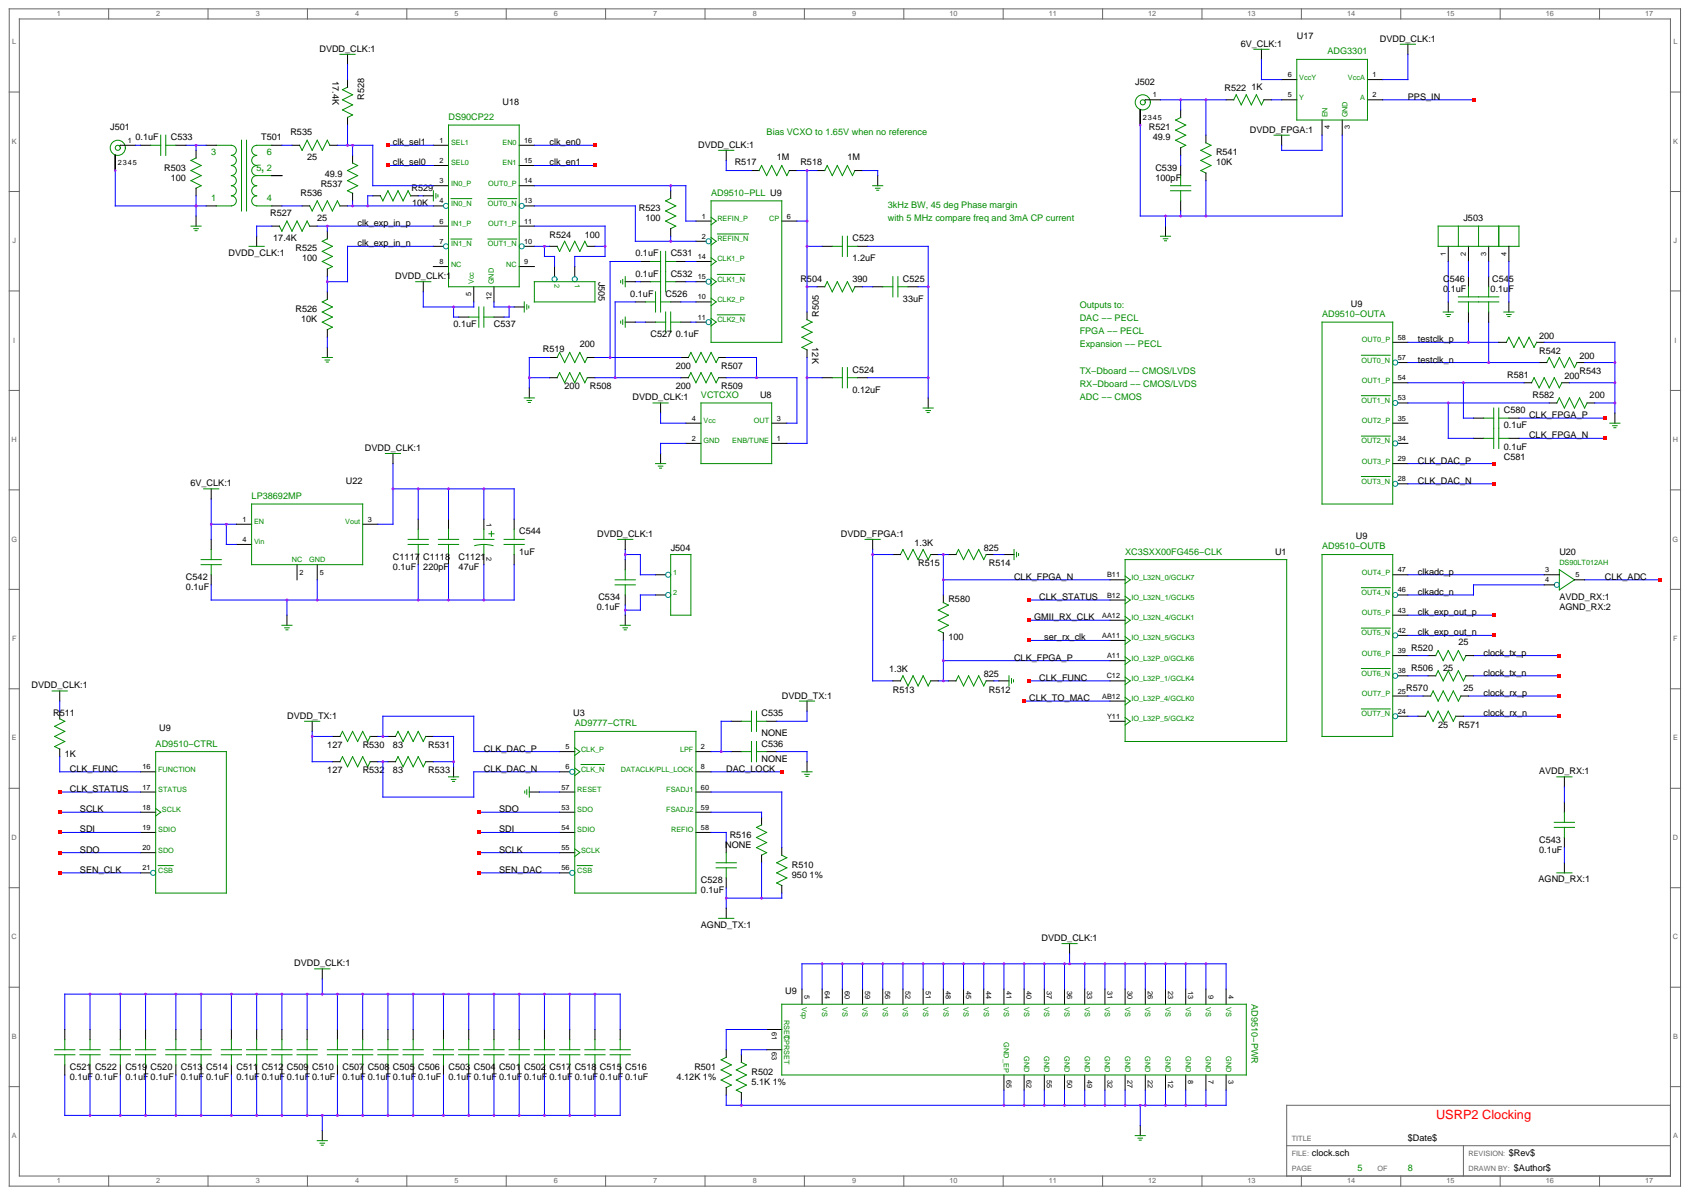
[picture p7: page 5]

Bias VCXO to 1.65V when no reference

3kHz BW, 45 deg Phase margin
with 5 MHz compare freq and 3mA CP current

TX−Dboard −− CMOS/LVDS
RX−Dboard −− CMOS/LVDS

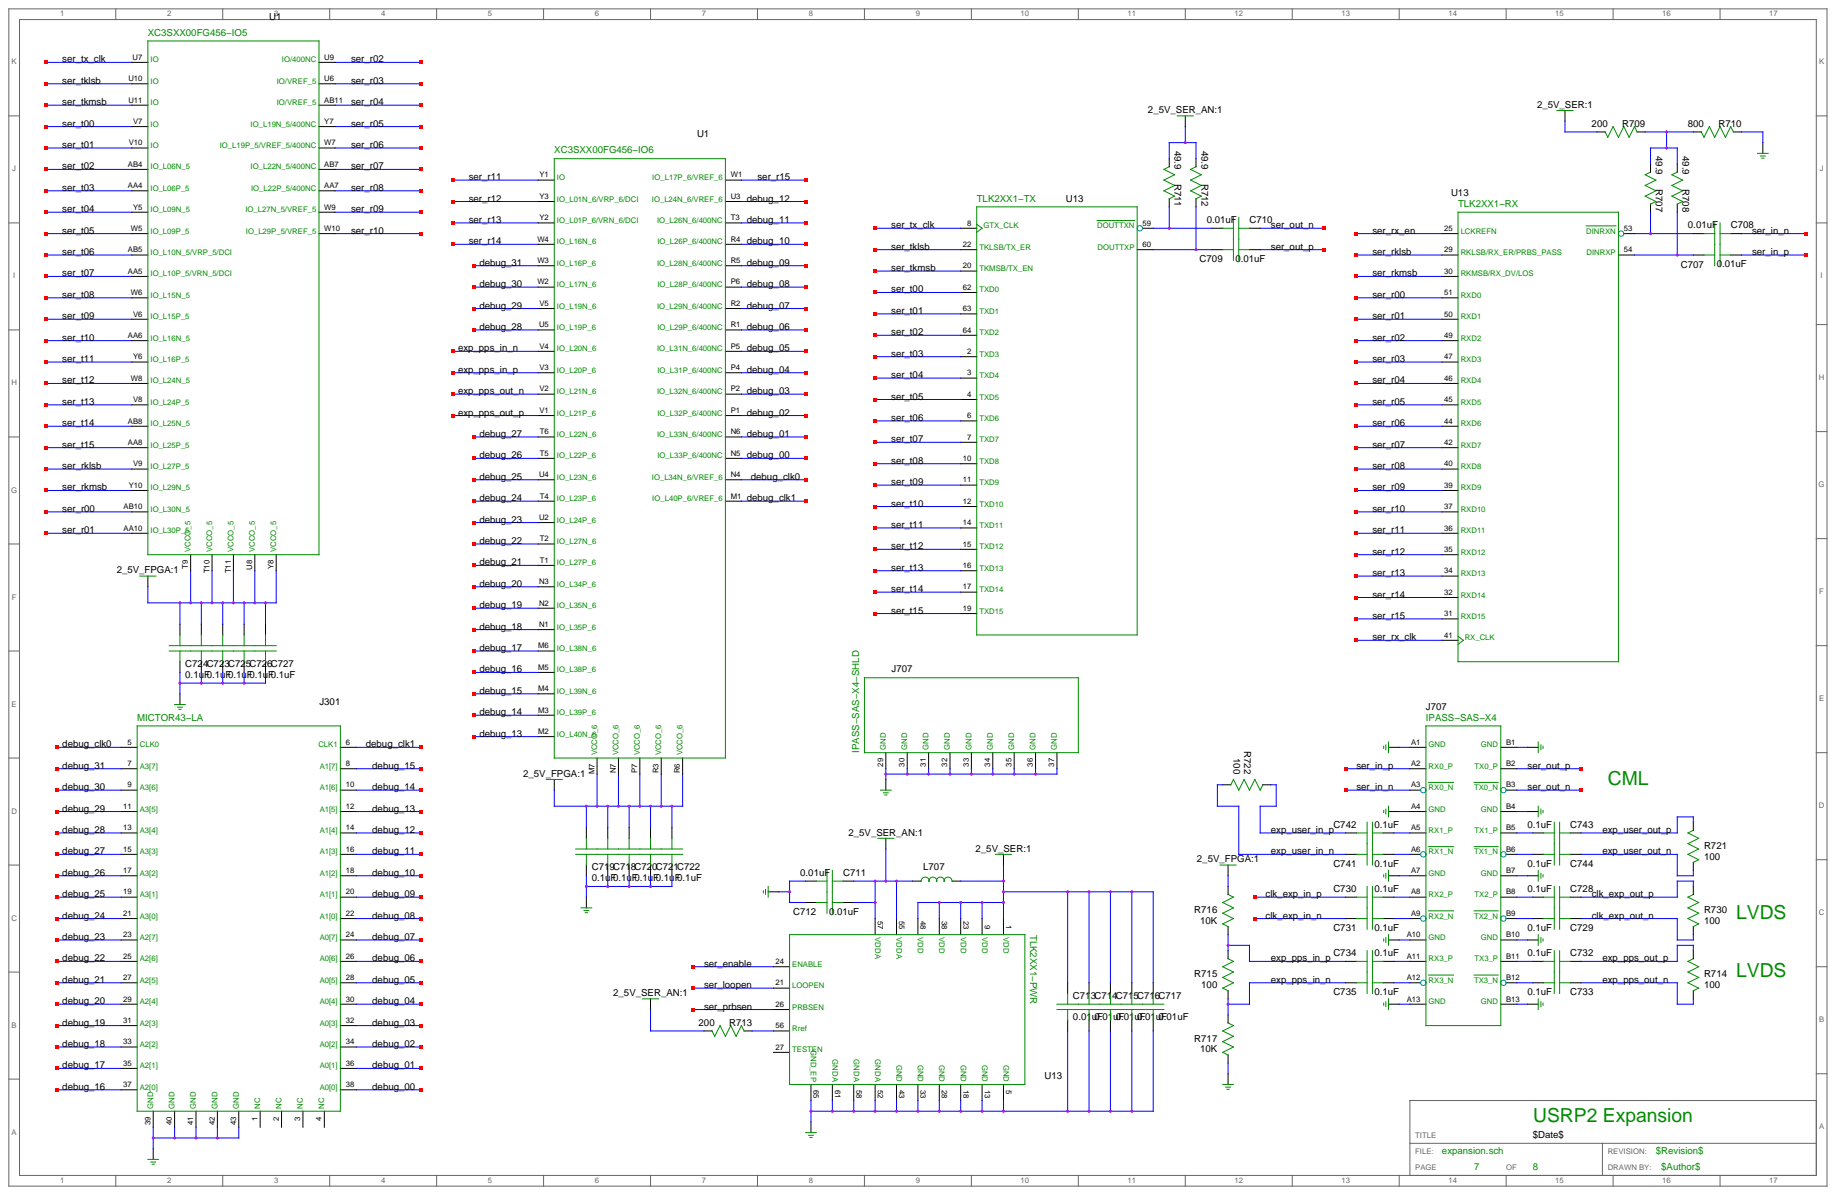
[picture p8: page 6]

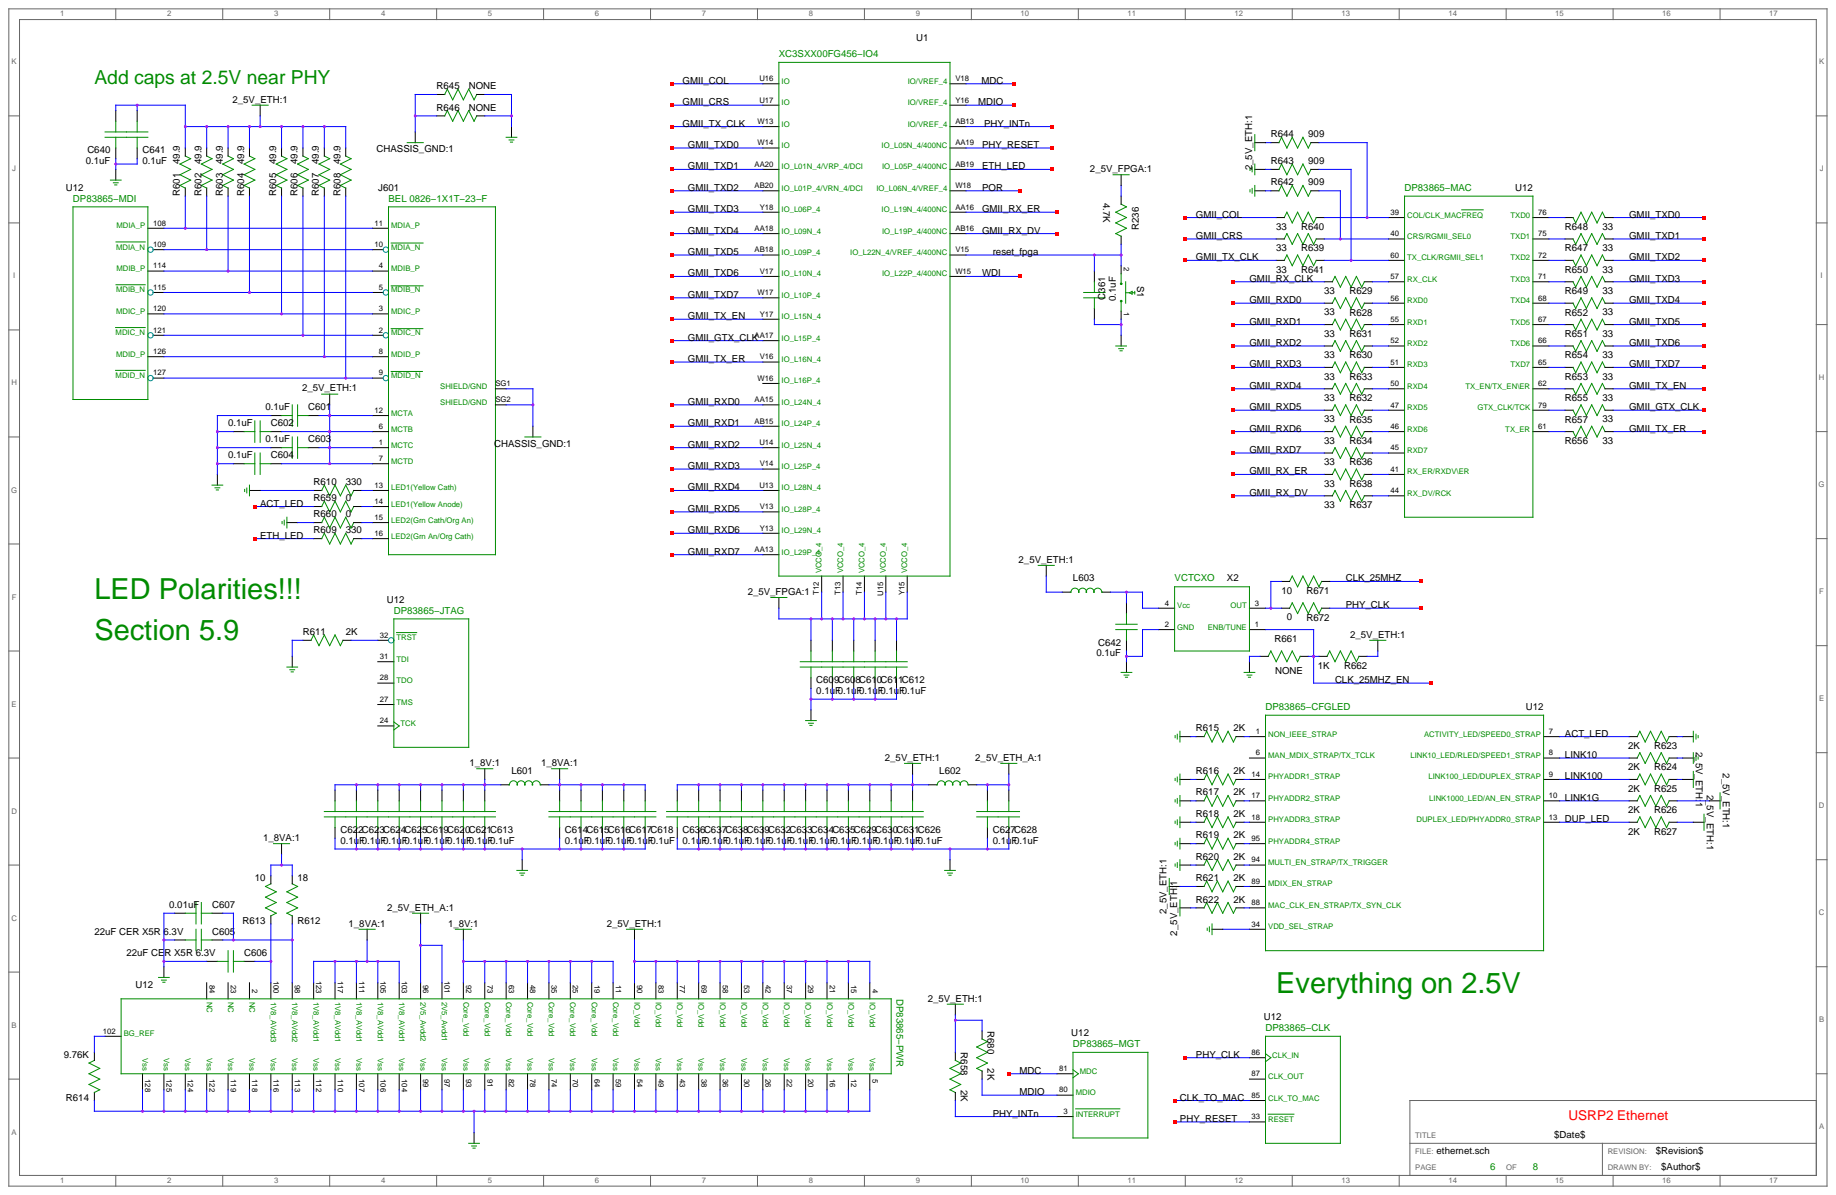
[picture p9: page 7]

Add caps at 2.5V near PHY

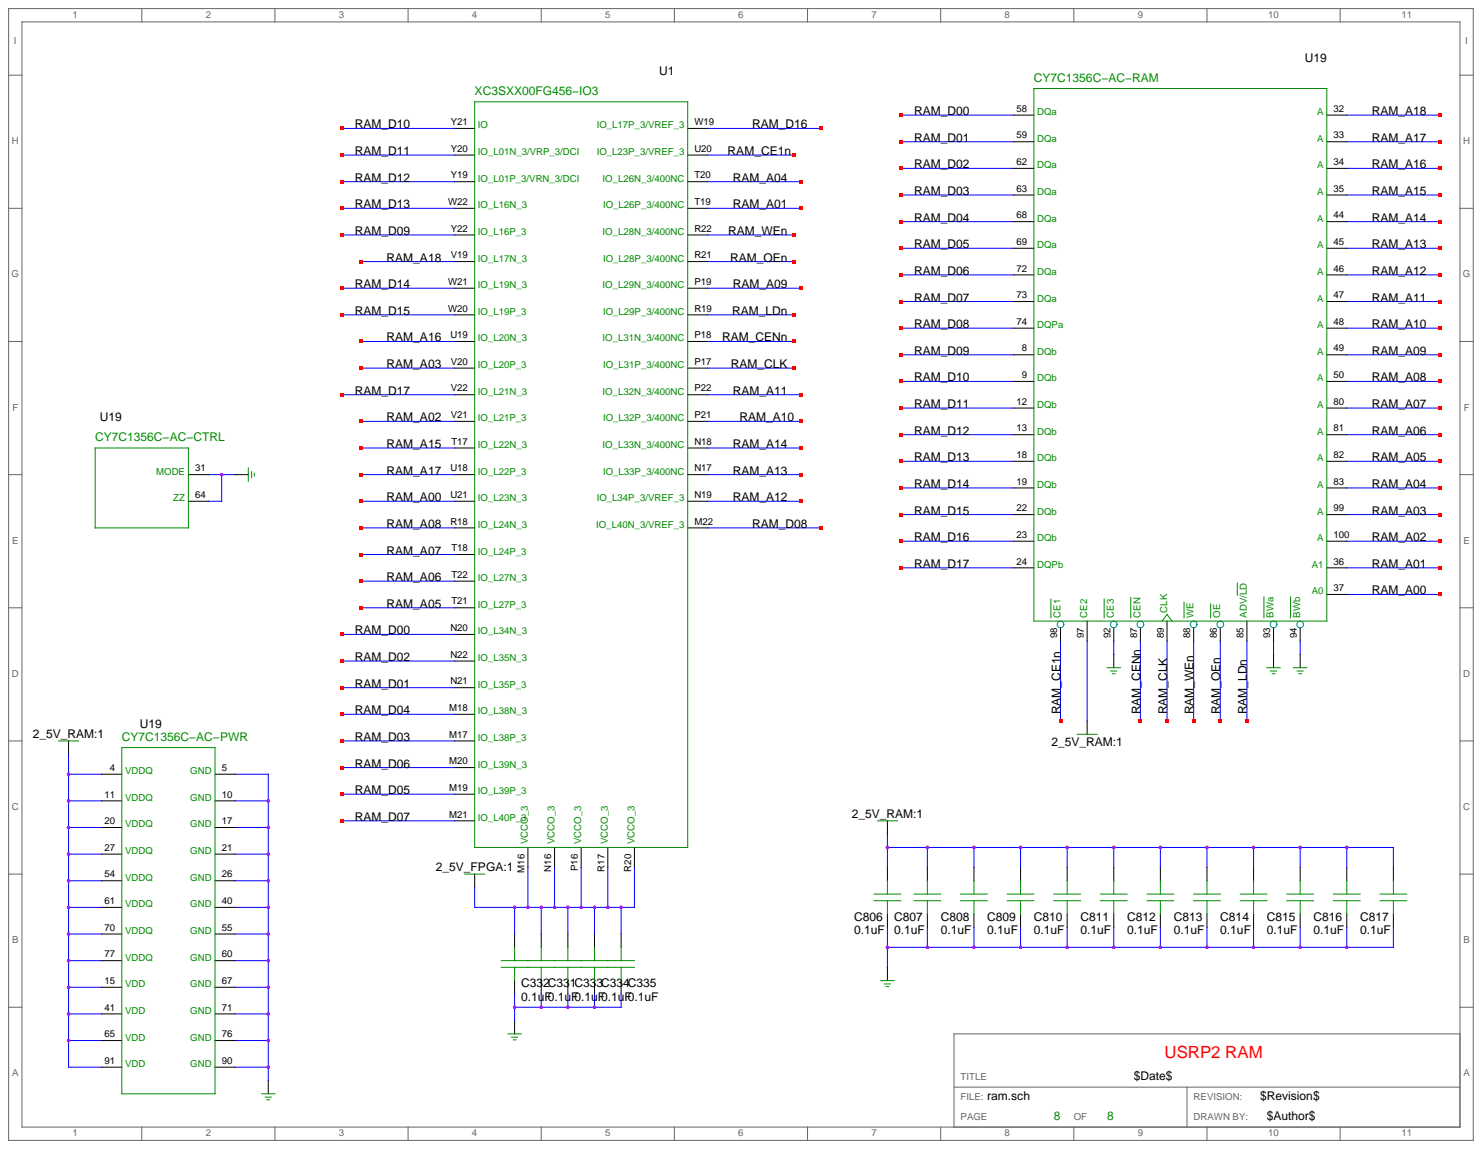
[picture p10: page 8]
