glocklueng/gnuRadio-hw/(list of files, drawings)

Other design files:
daughterBoards/anritsu_int/anr_int.pcb
daughterBoards/basic-dboard/rxmod.pcb
daughterBoards/basic-dboard/txmod.pcb
daughterBoards/basic-lf/lfrx.pcb
daughterBoards/basic-lf/lftx.pcb
daughterBoards/char-test/rxchar.pcb
daughterBoards/char-test/txchar.pcb
daughterBoards/clockfix/clockfix.pcb
daughterBoards/dbsrx/dbsrx.pcb
daughterBoards/rf-test/rf-test.pcb
daughterBoards/rfx/pcb/rfx400.pcb
daughterBoards/rfx/pcb/rfx900.pcb
daughterBoards/rfx/pcb/rfx2400.pcb
daughterBoards/tvrx/tvrx.pcb
daughterBoards/wbrx/wbrx.pcb
usrp1/usrp_mboard.pcb
